biomimetics/biomimetic-millisystems-lab/code/stanbaek/ledBlink/readme.txt

If this program is successfully loaded, the LEDs will be blinking.

This program needs main.c, delay.s, and init_default.c.

CPU: dsPIC33FJ128MC706A
Compiler version: MPLAB C30 Combo v3.24 Lite
IDE version: MPLAB IDE v8.56 
OS: Windows XP
