biomimetics/biomimetic-millisystems-lab/(list of files, cad)

Other CAD files:
boards/CameraBreakout/CameraBreakout_PCB.SLDDRW
