biomimetics/biomimetic-millisystems-lab/(list of files, drawings)

Other design files:
boards/ImageProc1/ImageProc-1-multiple/ImageProc-1-multiple.PCB
boards/ImageProc1/ImageProc-1.PCB
boards/MotorDriver1/MotorDriver-1-multiple/MotorDriver-1-multiple.PCB
boards/MotorDriver1/MotorDriver-1.PCB
