biomimetics/biomimetic-millisystems-lab/(commit log)

2011-05-02 Added camera breakout board v0.3.
    [CameraBreakout_PCB.SLDDRW]
2011-05-02 Uploading board source for ImageProc1.
    [ImageProc-1-multiple.PCB, ImageProc-1.PCB]
2011-05-02 Uploading board source for MotorDriver1.
    [MotorDriver-1-multiple.PCB, MotorDriver-1.PCB]
2011-05-25 Uploading ImageProc2 Introduction program: LED Blinking
2011-05-25 Uploading ImageProc2 codes to read IMU data - not working yet
    [cmd.c, main.c]
2011-07-01 Striping OVCAM_ definitions out of utils.h since they've been living in ovcam.h for over a year now and currently result in compilation warnings.
